ksn2/plant4you/readme.txt

git pull   to begin/ downloard new documents

working......

git status  verify not needed

git add *     add all documents

git commit -m "COMMENT"   commentiares  prepare uploard

git push    to finish    uploard

DO NOT REOMOVE ANYTHING
