ksn2/plant4you/Eagle files/projectdesign_v1.0_10ku.xlsx

Part Number | Manufacturer | Customer Ref | Qty for 1u | Qty for 10ku | Price (USD) | Extended Price (USD) | Buy Now Link
C1608X7S1C225K080AC | TDK Corporation of America | C1, C4 | 2 | 20000 | $0.0638 | $1275.2000 | BUY NOW (http://www.findchips.com/buyNow/REF31cc2016cbec4e1b73caca7a0ee76e62_1513636588540)
CL10C2R2BB8NNNC | Samsung Electro-Mechanics | C17, C18 | 2 | 20000 | $0.0047 | $94.0000 | BUY NOW (http://www.findchips.com/buyNow/REF4bc2c40f38a14b543147b131e5790f90_1513636588540)
GRM188R60J106KE47D | Murata Manufacturing Co Ltd | C2, C3, C5, C6, C7 | 5 | 50000 | $0.0260 | $1300.0000 | BUY NOW (http://www.findchips.com/buyNow/REF58e51c0d0c70fecfa8ddc1131338d9a8_1513636588540)
CL10B105KP8NNNC | Samsung Electro-Mechanics | C20 | 1 | 10000 | $0.0044 | $44.0000 | BUY NOW (http://www.findchips.com/buyNow/REF90674f444396d27626bddeaa0b6934d4_1513636588540)
C0402C104K8RACTU | KEMET Corporation | C8, C9, C11, C12, C13, C14, C15, C16 | 8 | 80000 | $0.0060 | $480.0000 | BUY NOW (http://www.findchips.com/buyNow/REF71b78460a80cd47184843153eb02b417_1513636588540)
1051330011 | Woodhead Molex | CN1 | 1 | 10000 | $0.3904 | $3904.0000 | BUY NOW (http://www.findchips.com/buyNow/REF39c8833fe5188c6ea10376dab894bd50_1513636588540)
S2B-PH-SM4-TB(LF)(SN) | JST Manufacturing | CN2 | 1 | 10000 | $0.3155 | $3155.2000 | BUY NOW (http://www.findchips.com/buyNow/REFdc34bc6eb77acfec8c5d5d912a447aa0_1513636588540)
1N4148W-7-F | SPC Multicomp | D1, D2, D3, D4 | 4 | 40000 | $0.0120 | $480.0000 | BUY NOW (http://www.findchips.com/buyNow/REFe81a3cc093ba35d7bd46322f07d6a9f4_1513636588540)
TPS73233DBVT | Texas Instruments | IC1, IC2 | 2 | 20000 | $0.8500 | $17000.0000 | BUY NOW (http://www.findchips.com/buyNow/REFb6842c236441bab0f91dbeda015d57be_1513636588540)
MCP73833T-AMI/UN | Microchip Technology Inc | IC3 | 1 | 10000 | $0.6902 | $6902.0000 | BUY NOW (http://www.findchips.com/buyNow/REF55941f5b56751ebd3785dd3f0201f68b_1513636588540)
ATMEGA32U4RC-AUR | Microchip Technology Inc | IC4 | 1 | 10000 | $3.1300 | $31300.0000 | BUY NOW (http://www.findchips.com/buyNow/REF8bca17bd0259d9e86a0e12016a883257_1513636588540)
TLV379IDBVT | Texas Instruments | IC5 | 1 | 10000 | $0.2648 | $2648.0000 | BUY NOW (http://www.findchips.com/buyNow/REFf75a09880d05cdd1fed671623121a951_1513636588540)
61302221021 | Wurth Electronics Midcom | JP1 | 1 | 10000 | $0.7200 | $7200.0000 | BUY NOW (http://www.findchips.com/buyNow/REFa60be67211f2c4d99c35d25056d53b82_1513636588540)
PRPC025SAAN-RC | Sullins Connector Solutions | JP2 | 1 | 10000 | $0.2395 | $2394.8000 | BUY NOW (http://www.findchips.com/buyNow/REF61615c5b441bf2df4b6aa6ea3f7fab22_1513636588540)
LQM18PN3R3MGHD | Murata Manufacturing Co Ltd | L1, L2 | 2 | 20000 | $0.1896 | $3792.8000 | BUY NOW (http://www.findchips.com/buyNow/REF9090d8d61cc638534848b6033a871ce6_1513636588540)
WP154A4SEJ3VBDZGW/CA | Kingbright | LD1, LD2 | 2 | 20000 | $0.7312 | $14625.0000 | BUY NOW (http://www.findchips.com/buyNow/REF5d757407a6ffb510d0d9354856d090c1_1513636588540)
TLHO4400 | Vishay Intertechnologies | LD3 | 1 | 10000 | $0.0750 | $750.0000 | BUY NOW (http://www.findchips.com/buyNow/REF917523fed8f101329e66d244f764203b_1513636588540)
TLLG4400 | Vishay Semiconductors | LD4 | 1 | 10000 | $0.0735 | $735.0000 | BUY NOW (http://www.findchips.com/buyNow/REF6d5565322f12cf7d5e41bd07beffc5d7_1513636588540)
TLHK4600 | Vishay Intertechnologies | LD5 | 1 | 10000 | $0.1190 | $1190.0077 | BUY NOW (http://www.findchips.com/buyNow/REF79d3afbc32bd740dc5758215182803e2_1513636588540)
CEM-1203(42) | CUI Inc | LS1 | 1 | 10000 | $0.4040 | $4040.0000 | BUY NOW (http://www.findchips.com/buyNow/REF7d50d23c2ce48577a59e85f5f175b530_1513636588540)
T2N7002BK,LM | Toshiba America Electronic Components | Q1, Q2, Q3, Q4, Q5 | 5 | 50000 | $0.0170 | $850.0000 | BUY NOW (http://www.findchips.com/buyNow/REFca5b4d7ef96829eccc1e313a39a78037_1513636588540)
ERJ-3EKF2001V | Panasonic Electronic Components | R01, R02, R03, R09, R27, R28, R29 | 7 | 70000 | $0.0043 | $301.0000 | BUY NOW (http://www.findchips.com/buyNow/REFb075da1d5211cd85118a7cf6484cde3e_1513636588540)
161 | Adafruit Industries | R04 | 1 | 10000 | $0.9500 | $9500.0000 | BUY NOW (http://www.findchips.com/buyNow/REF6a314e36687fc0da8680494a4f7a349a_1513636588540)
RC0603JR-0710KL | YAGEO Corporation | R05, R10, R11, R12, R14, R15, R16, R19, R20, R21, R22, R23, R24, R25, R26, R30, R31 | 17 | 170000 | $0.0010 | $170.0000 | BUY NOW (http://www.findchips.com/buyNow/REF34265a9543ca0835692e1984bb5d935d_1513636588540)
RC0603FR-071KL | YAGEO Corporation | R06, R07, R08 | 3 | 30000 | $0.0010 | $30.0000 | BUY NOW (http://www.findchips.com/buyNow/REFd454bf327c9d5965a2a90ef37af13bb2_1513636588540)
RC0603JR-07330RL | YAGEO Corporation | R13 | 1 | 10000 | $0.0010 | $10.0000 | BUY NOW (http://www.findchips.com/buyNow/REF4f86663b7a59056d9bbcf79774f7c605_1513636588540)
RC0603JR-0722RL | YAGEO Corporation | R17, R18 | 2 | 20000 | $0.0010 | $20.0000 | BUY NOW (http://www.findchips.com/buyNow/REF3a03c2ac452e0722e72d15b519151ccf_1513636588540)
ABM3B-8.000MHZ-B2-T | Abracon Corporation | Y1 | 1 | 10000 | $0.3000 | $3000.0000 | BUY NOW (http://www.findchips.com/buyNow/REF757090e3209aa773c61a521414b3ed73_1513636588540)
P160KNP-0QC20B100K | TT electronics / BI Technologies | Potentiometer | 2 | 20000 | $0.3410 | $6820.0000 | BUY NOW (http://www.findchips.com/buyNow/REF6512f6ffeaa8bfea2acfd3cbcc9c324e_1513636588540)
RD1113112R | E-Switch Inc | Switch ON/OFF | 1 | 10000 | $0.4169 | $4169.5000 | BUY NOW (http://www.findchips.com/buyNow/REFc520fa1013096d44ad12100beb26c609_1513636588540)
SEN-13285 | SparkFun Electronics | PIR detector | 1 | 10000 | $9.9500 | $99500.0000 | BUY NOW (http://www.findchips.com/buyNow/REF5ceba9085f9713bd4fbd4c60f31d63c7_1513636588540)
59630-1-T-02-F | Littelfuse Inc | Level Sensor | 1 | 10000 | $3.6525 | $36524.9890 | BUY NOW (http://www.findchips.com/buyNow/REFe3c43dcab0f1088a73c3406c82f90f47_1513636588540)
1227-L | Davies Molding LLC | button / knobs | 4 | 40000 | $0.5250 | $21000.0000 | BUY NOW (http://www.findchips.com/buyNow/REF950a1c00edf912bbf072bdf14b88454a_1513636588540)
Total: |  |  |  |  | $24.4704 | $285205.4967
List URL http://www.... (http://www.findchips.com/listExportUrl/REFb71df46670677b38f3765c6fa840ecae_1513636588540)
