ksn2/plant4you/Eagle files/projectdesign_v1.0.xlsx

Part Number | Manufacturer | Customer Ref | Requested Qty | Price (USD) | Extended Price (USD) | Buy Now Link | Datasheet Link
C1608X7S1C225K080AC | TDK Corporation of America | C1, C4 | 6 | $0.2700 | $1.6200 | BUY NOW (http://www.findchips.com/buyNow/REFf66b751d84ed0f5c17d27a477af12626_1511742619100)
CL10C2R2BB8NNNC | Samsung Electro-Mechanics | C17, C18 | 6 | $0.1000 | $0.6000 | BUY NOW (http://www.findchips.com/buyNow/REFc5286166dd49acb642db3adea9a44607_1511742619100) | DOWNLOAD (http://www.findchips.com/downloadDs/REF1f4d97d7e42095225d08ddc651603f1e_1511742619100)
GRM188R60J106KE47D | Murata Manufacturing Co Ltd | C2, C3, C5, C6, C7 | 15 | $0.1090 | $1.6350 | BUY NOW (http://www.findchips.com/buyNow/REFb6cca2449dfc87572ddc5fba2605cb44_1511742619100) | DOWNLOAD (http://www.findchips.com/downloadDs/REF019bca1aee656d7ac1753f8d0c4d76cc_1511742619100)
CL10B105KP8NNNC | Samsung Electro-Mechanics | C20 | 3 | $0.1000 | $0.3000 | BUY NOW (http://www.findchips.com/buyNow/REF77f5892608f1419121ff32fcdfdb78a2_1511742619100) | DOWNLOAD (http://www.findchips.com/downloadDs/REF6c7af745d2b4565f88028a2741715127_1511742619100)
C0402C104K8RACTU | KEMET Corporation | C8, C9, C11, C12, C13, C14, C15, C16 | 24 | $0.0330 | $0.7920 | BUY NOW (http://www.findchips.com/buyNow/REFa5c6ad6ed951c9613644b0c759223baf_1511742619100) | DOWNLOAD (http://www.findchips.com/downloadDs/REF34f89f49994c7fe76e5298d0db0d848e_1511742619100)
1051330011 | Molex | CN1 | 3 | $1.0600 | $3.1800 | BUY NOW (http://www.findchips.com/buyNow/REFa73fe93963815aad48f86f9a9810aae7_1511742619100)
S2B-PH-SM4-TB(LF)(SN) | JST Manufacturing | CN2 | 3 | $0.5800 | $1.7400 | BUY NOW (http://www.findchips.com/buyNow/REF6368ca78605b86df658b20e4bdfd3f86_1511742619100) | DOWNLOAD (http://www.findchips.com/downloadDs/REF21815601e099eef7dc836e262553e640_1511742619100)
1N4148W-7-F | Diodes Incorporated | D1, D2, D3, D4 | 12 | $0.1640 | $1.9680 | BUY NOW (http://www.findchips.com/buyNow/REF012d256c0f24fd18d2a83f3bec859747_1511742619100) | DOWNLOAD (http://www.findchips.com/downloadDs/REF70821d2a931a5c306895712638c58a9a_1511742619100)
TPS73233DBVT | Texas Instruments | IC1, IC2 | 6 | $1.5700 | $9.4200 | BUY NOW (http://www.findchips.com/buyNow/REFd1458502e79fef33ecda44f013d2832b_1511742619100) | DOWNLOAD (http://www.findchips.com/downloadDs/REF4627096593f59883d910f3811baa2f1d_1511742619100)
MCP73833T-AMI/UN | Microchip Technology Inc | IC3 | 3 | $0.8900 | $2.6700 | BUY NOW (http://www.findchips.com/buyNow/REF0acb44e07918c3e2da592dfd7adbda82_1511742619100) | DOWNLOAD (http://www.findchips.com/downloadDs/REFc16c9a63c8e0155e4dbd9554bb5b1c9d_1511742619100)
ATMEGA32U4RC-AUR | Microchip Technology Inc | IC4 | 3 | $4.2900 | $12.8700 | BUY NOW (http://www.findchips.com/buyNow/REFb91479fa1f48abb75d063cb36a217ecc_1511742619100)
TLV379IDBVT | Texas Instruments | IC5 | 3 | $0.7800 | $2.3400 | BUY NOW (http://www.findchips.com/buyNow/REF6a3a97474f5e63c49e5ae6d3cdcc2bd5_1511742619100) | DOWNLOAD (http://www.findchips.com/downloadDs/REF2c472c6e22e121a1499769ffbed5d0ea_1511742619100)
61302221021 | Wurth Electronics Midcom | JP1 | 3 | $1.4800 | $4.4400 | BUY NOW (http://www.findchips.com/buyNow/REFd0724fc2f9bac6cddea9f2bb1691e8f2_1511742619100)
PRPC025SAAN-RC | Sullins Connector Solutions | JP2 | 3 | $0.5500 | $1.6500 | BUY NOW (http://www.findchips.com/buyNow/REF89ff7de83079121413192e5261189aa6_1511742619100)
LQM18PN3R3MGHD | Murata Manufacturing Co Ltd | L1, L2 | 6 | $0.4500 | $2.7000 | BUY NOW (http://www.findchips.com/buyNow/REF6983d0bacdc3b7179c31344df58abc18_1511742619100)
WP154A4SEJ3VBDZGW/CA | Kingbright | LD1, LD2 | 6 | $2.0500 | $12.3000 | BUY NOW (http://www.findchips.com/buyNow/REF72d246a25f8a70af345e91291218c92f_1511742619100)
TLHO4400 | Vishay Semiconductors | LD3 | 3 | $0.5200 | $1.5600 | BUY NOW (http://www.findchips.com/buyNow/REF5b3f9c1bb6ac76b9f6830ea67775394e_1511742619100) | DOWNLOAD (http://www.findchips.com/downloadDs/REF6d4dd64f37a5870487dc8fe0a707be59_1511742619100)
TLLG4400 | Vishay Semiconductors | LD4 | 3 | $0.5000 | $1.5000 | BUY NOW (http://www.findchips.com/buyNow/REF671e45b739c328b1c66ff7fe57683592_1511742619100) | DOWNLOAD (http://www.findchips.com/downloadDs/REFd5734a7edfee3f9d948d6d67250f2df7_1511742619100)
TLHK4600 | Vishay Semiconductors | LD5 | 3 | $0.4400 | $1.3200 | BUY NOW (http://www.findchips.com/buyNow/REFb7131e319e8513b46af3da1528d08bba_1511742619100) | DOWNLOAD (http://www.findchips.com/downloadDs/REFf0eb19955a43db84a89d9b4394bf1b00_1511742619100)
CEM-1203(42) | CUI Inc | LS1 | 3 | $0.9700 | $2.9100 | BUY NOW (http://www.findchips.com/buyNow/REFb883de1dff0d67a19fbf12e010912da7_1511742619100)
T2N7002BK,LM | Toshiba America Electronic Components | Q1, Q2, Q3, Q4, Q5 | 15 | $0.1710 | $2.5650 | BUY NOW (http://www.findchips.com/buyNow/REF7df44703fd0e53d011f4c2e0d8a4afd9_1511742619100)
ERJ-3EKF2001V | Panasonic Electronic Components | R01, R02, R03, R09, R27, R28, R29 | 21 | $0.0570 | $1.1970 | BUY NOW (http://www.findchips.com/buyNow/REFe0275140c9dfc09d22c0b8cd24d6f4d1_1511742619100) | DOWNLOAD (http://www.findchips.com/downloadDs/REFd24328abf190c49f8a6240d556954945_1511742619100)
161 | Adafruit Industries | R04 | 3 | $0.9500 | $2.8500 | BUY NOW (http://www.findchips.com/buyNow/REF60ae9b95788bac3980c18a843a1e1d8b_1511742619100)
RC0603JR-0710KL | YAGEO Corporation | R05, R10, R11, R12, R14, R15, R16, R19, R20, R21, R22, R23, R24, R25, R26, R30, R31 | 51 | $0.0110 | $0.5610 | BUY NOW (http://www.findchips.com/buyNow/REFc91f549d2d90fc0bbecf7969e530a23f_1511742619100) | DOWNLOAD (http://www.findchips.com/downloadDs/REFb57fbb8a35e9925bec2339074d13de73_1511742619100)
RC0603FR-071KL | YAGEO Corporation | R06, R07, R08 | 9 | $0.1000 | $0.9000 | BUY NOW (http://www.findchips.com/buyNow/REF8fb07a13f801c52311ce77ef6def12a6_1511742619100) | DOWNLOAD (http://www.findchips.com/downloadDs/REFf692b2c74ec9d3cc190921a5e43ae7c4_1511742619100)
RC0603JR-07330RL | YAGEO Corporation | R13 | 3 | $0.1000 | $0.3000 | BUY NOW (http://www.findchips.com/buyNow/REF654be526baca869dc6ee3da60667c46d_1511742619100) | DOWNLOAD (http://www.findchips.com/downloadDs/REF1186b163d541c4794ce3fb4ad02fb3fa_1511742619100)
RC0603JR-0722RL | YAGEO Corporation | R17, R18 | 6 | $0.1000 | $0.6000 | BUY NOW (http://www.findchips.com/buyNow/REF78f071630f98e2ce599816b429543163_1511742619100) | DOWNLOAD (http://www.findchips.com/downloadDs/REF7aaa764fddc9c214c2c5ca3bd74b0005_1511742619100)
ABM3B-8.000MHZ-B2-T | Abracon Corporation | Y1 | 3 | $0.5100 | $1.5300 | BUY NOW (http://www.findchips.com/buyNow/REF8c2bad44a26a58ff95615c68a71c80fa_1511742619100)
P160KNP-0QC20B100K | TT electronics / BI Technologies | Potentiometer | 6 | $0.7600 | $4.5600 | BUY NOW (http://www.findchips.com/buyNow/REF2712a89083bef628c255b89755f665e8_1511742619100)
RD1113112R | E-Switch Inc | Switch ON/OFF | 2 | $0.6700 | $1.3400 | BUY NOW (http://www.findchips.com/buyNow/REF0045482cb7ad0e921a08addfb43c8513_1511742619100)
SEN-13285 | SparkFun Electronics | PIR detector | 2 | $9.9500 | $19.9000 | BUY NOW (http://www.findchips.com/buyNow/REF6ac73788b93b1b05acd4217cd8745597_1511742619100)
59630-1-T-02-F | Littelfuse Inc | Level Sensor | 1 | $7.1300 | $7.1300 | BUY NOW (http://www.findchips.com/buyNow/REF958e13c775bc0716d519fc51487d352f_1511742619100)
1227-L | Davies Molding LLC | button | 4 | $1.0900 | $4.3600 | BUY NOW (http://www.findchips.com/buyNow/REF9d3521369fd96be21a00488a76209cf6_1511742619100)
2003 | Adafruit Industries | wires | 1 | $0.7500 | $0.7500 | BUY NOW (http://www.findchips.com/buyNow/REFdd2375e230017ac7052d605e40d0c0c6_1511742619100)
2004 | Adafruit Industries | wires | 1 | $0.7500 | $0.7500 | BUY NOW (http://www.findchips.com/buyNow/REF9f839b3c856ede117d703e720ed7519c_1511742619100)
2001 | Adafruit Industries | wires | 1 | $0.7500 | $0.7500 | BUY NOW (http://www.findchips.com/buyNow/REF2a5c5912f52e5bdeeb570d007e2fbad9_1511742619100)
2005 | Adafruit Industries | wires | 1 | $0.7500 | $0.7500 | BUY NOW (http://www.findchips.com/buyNow/REF571c9d593df2cfcef382c5c8c4de9343_1511742619100)
2006 | Adafruit Industries | wires | 1 | $0.7500 | $0.7500 | BUY NOW (http://www.findchips.com/buyNow/REFac832c068813ad7eec9bb011f5001f67_1511742619100)
2002 | Adafruit Industries | wires | 1 | $0.7500 | $0.7500 | BUY NOW (http://www.findchips.com/buyNow/REF74df2bf7fa230bc32681d80d5187b0e0_1511742619100)
A02KR02KR26E51B | JST Manufacturing | battery connector head | 2 | $0.8600 | $1.7200 | BUY NOW (http://www.findchips.com/buyNow/REFa8ba24af6574b9d00f0fedf2d55a5b6f_1511742619100)
50579002 | Molex | wire head | 20 | $0.3150 | $6.3000 | BUY NOW (http://www.findchips.com/buyNow/REFa9f090160a2910a77b422dad1c59c576_1511742619100) | DOWNLOAD (http://www.findchips.com/downloadDs/REF4f7ca95ae4dcf72a3f6897b211605166_1511742619100)
1903115-2 | TE Connectivity Ltd | wire head | 20 | $0.2340 | $4.6800 | BUY NOW (http://www.findchips.com/buyNow/REF2e6c435b52858ef2cd3f6d3dbd0b8d43_1511742619100)
104481-2 | TE Connectivity Ltd | wire head | 20 | $0.1350 | $2.7000 | BUY NOW (http://www.findchips.com/buyNow/REF591973ddf7f70e00231eeb661dc71fe9_1511742619100) | DOWNLOAD (http://www.findchips.com/downloadDs/REF733cad3b3655ea9fa18c4a471f4d21d7_1511742619100)
Q2-F-3/64-01-QB48IN-25 | Qualtek Electronics Corporation | heat shirnkable tube | 1 | $0.3700 | $0.3700 | BUY NOW (http://www.findchips.com/buyNow/REF7b3daf2aafc5852abaa0eb33fb0964ff_1511742619100)
Total |  |  |  |  | $135.5780
List URL http://www.... (http://www.findchips.com/listExportUrl/REF6744603b5e4ae30d0f72f0af92319cf2_1511742619100)
