ksn2/plant4you/Eagle files/Project_design_v1.1.pdf

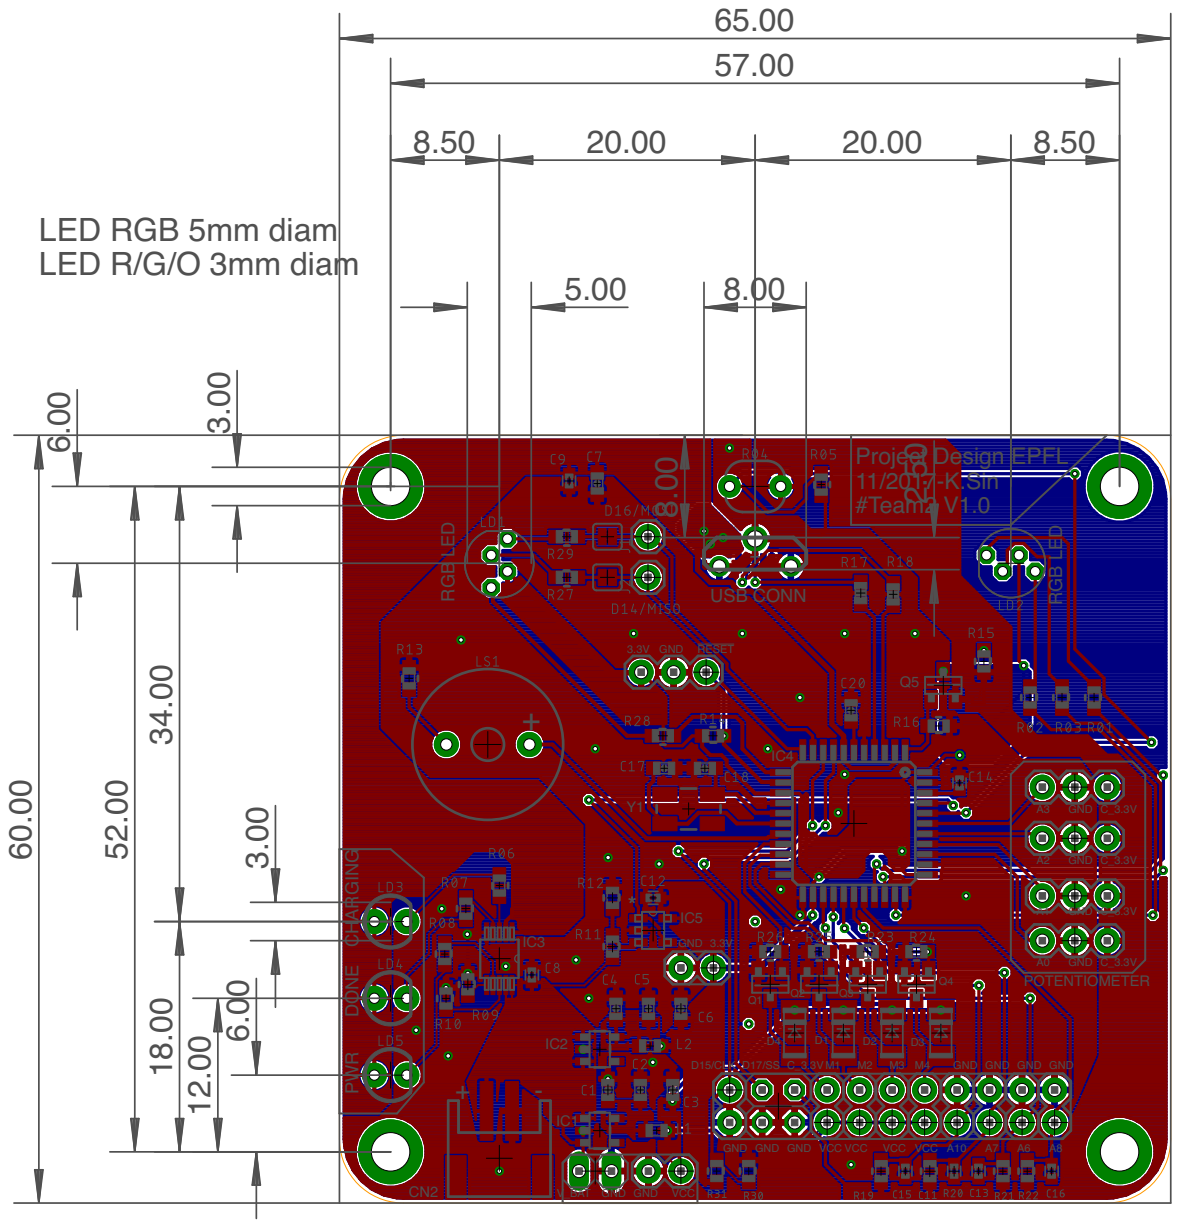
[picture p1: page 1]

3.3V GND RESET

GND GND

IC3 | GND 3.3V

VCC VCC
