ksn2/plant4you/Eagle files/Project_design_v1.0_top.pdf

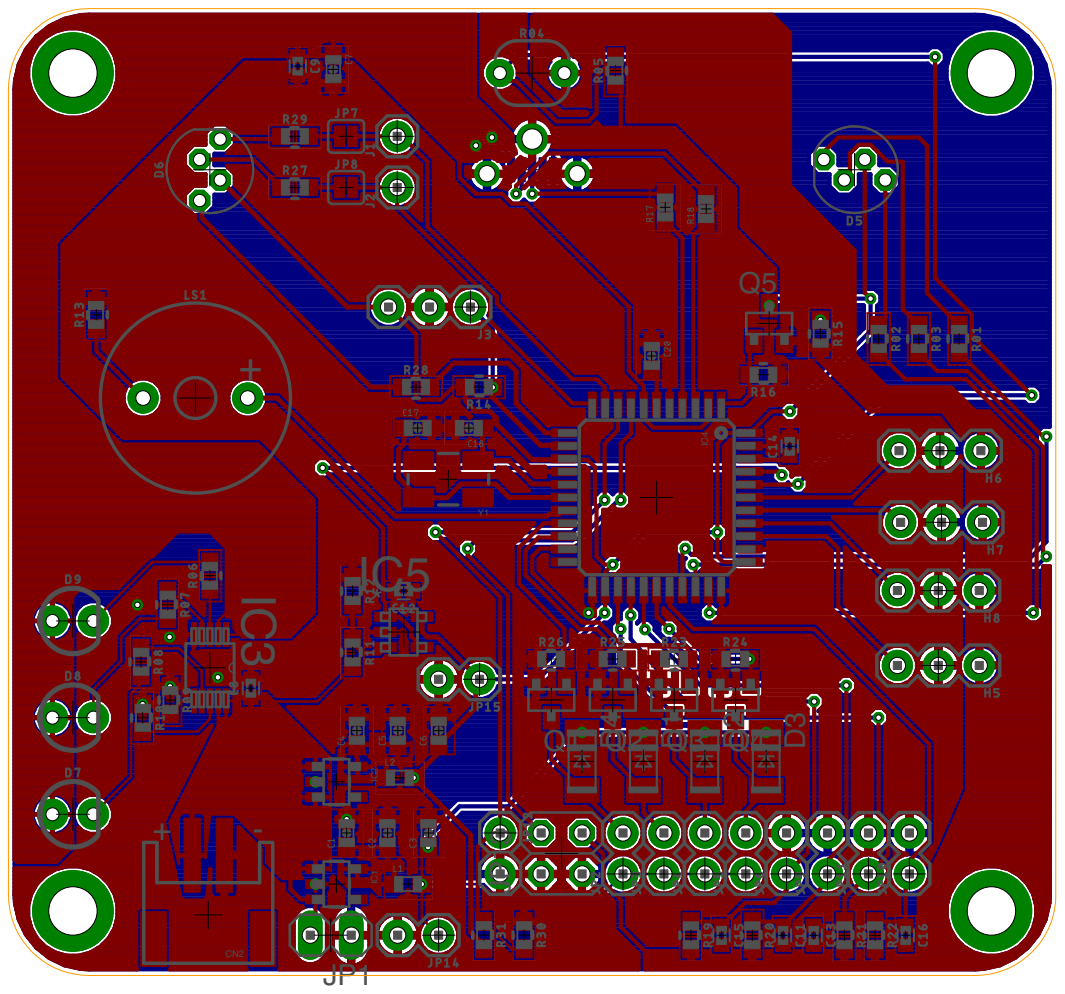
[picture p2: page 1]

Y1
IC5
