ksn2/plant4you/Eagle files/Project_design_v1.0.pdf

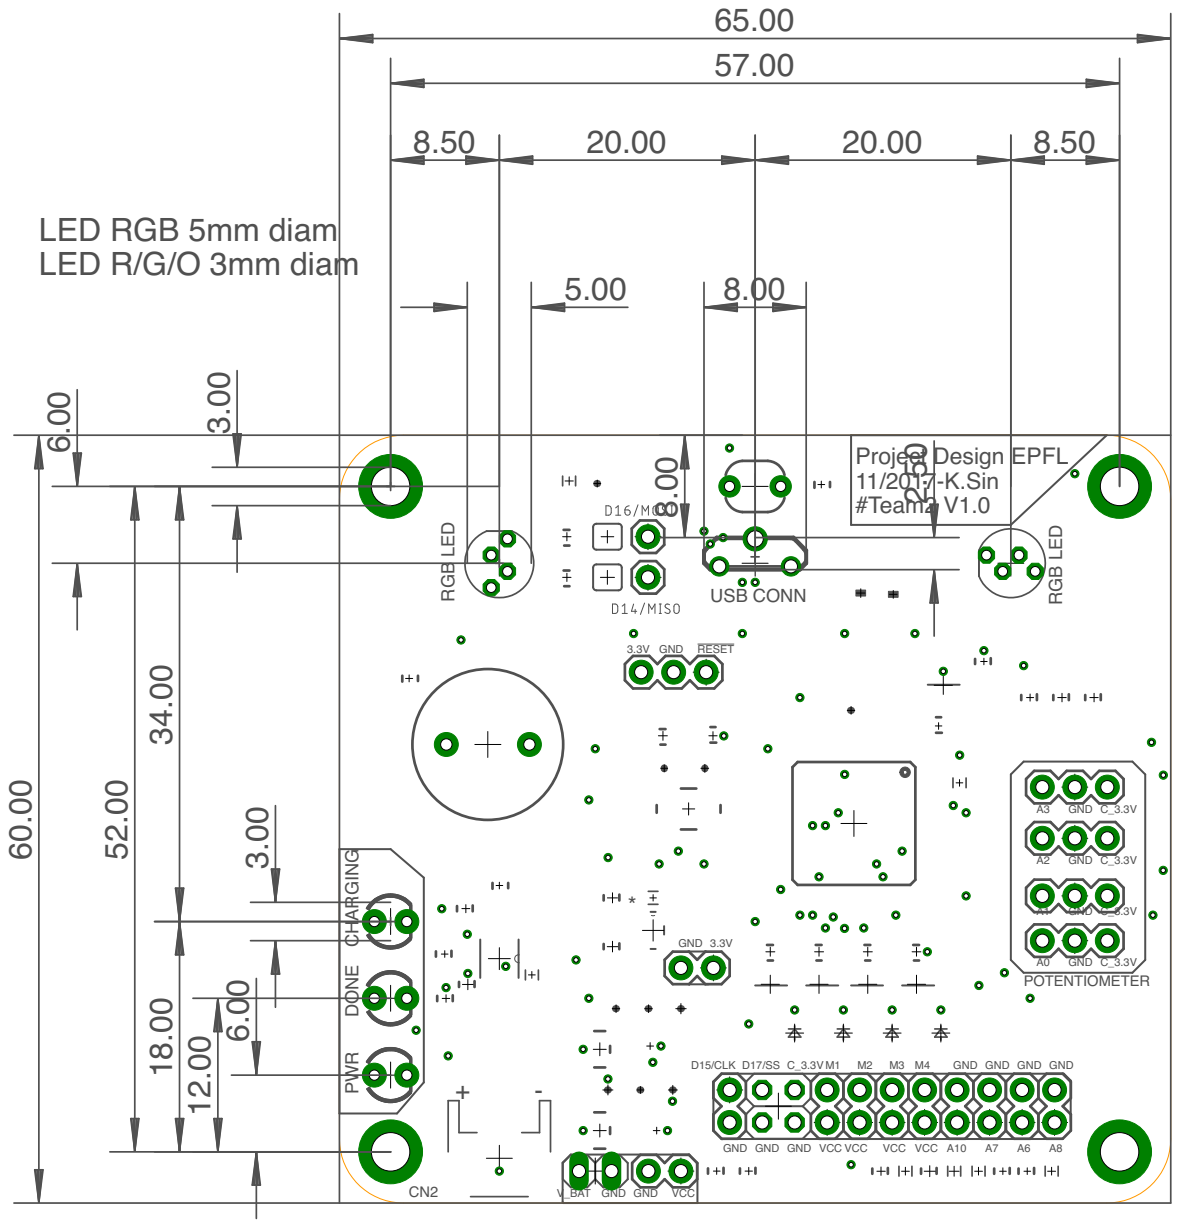
[picture p3: page 1]

GND GND
