ksn2/plant4you/Eagle files/Project_design_v1.0.brd

## EAGLE design Eagle files/Project_design_v1.0.brd (2017-11-29)

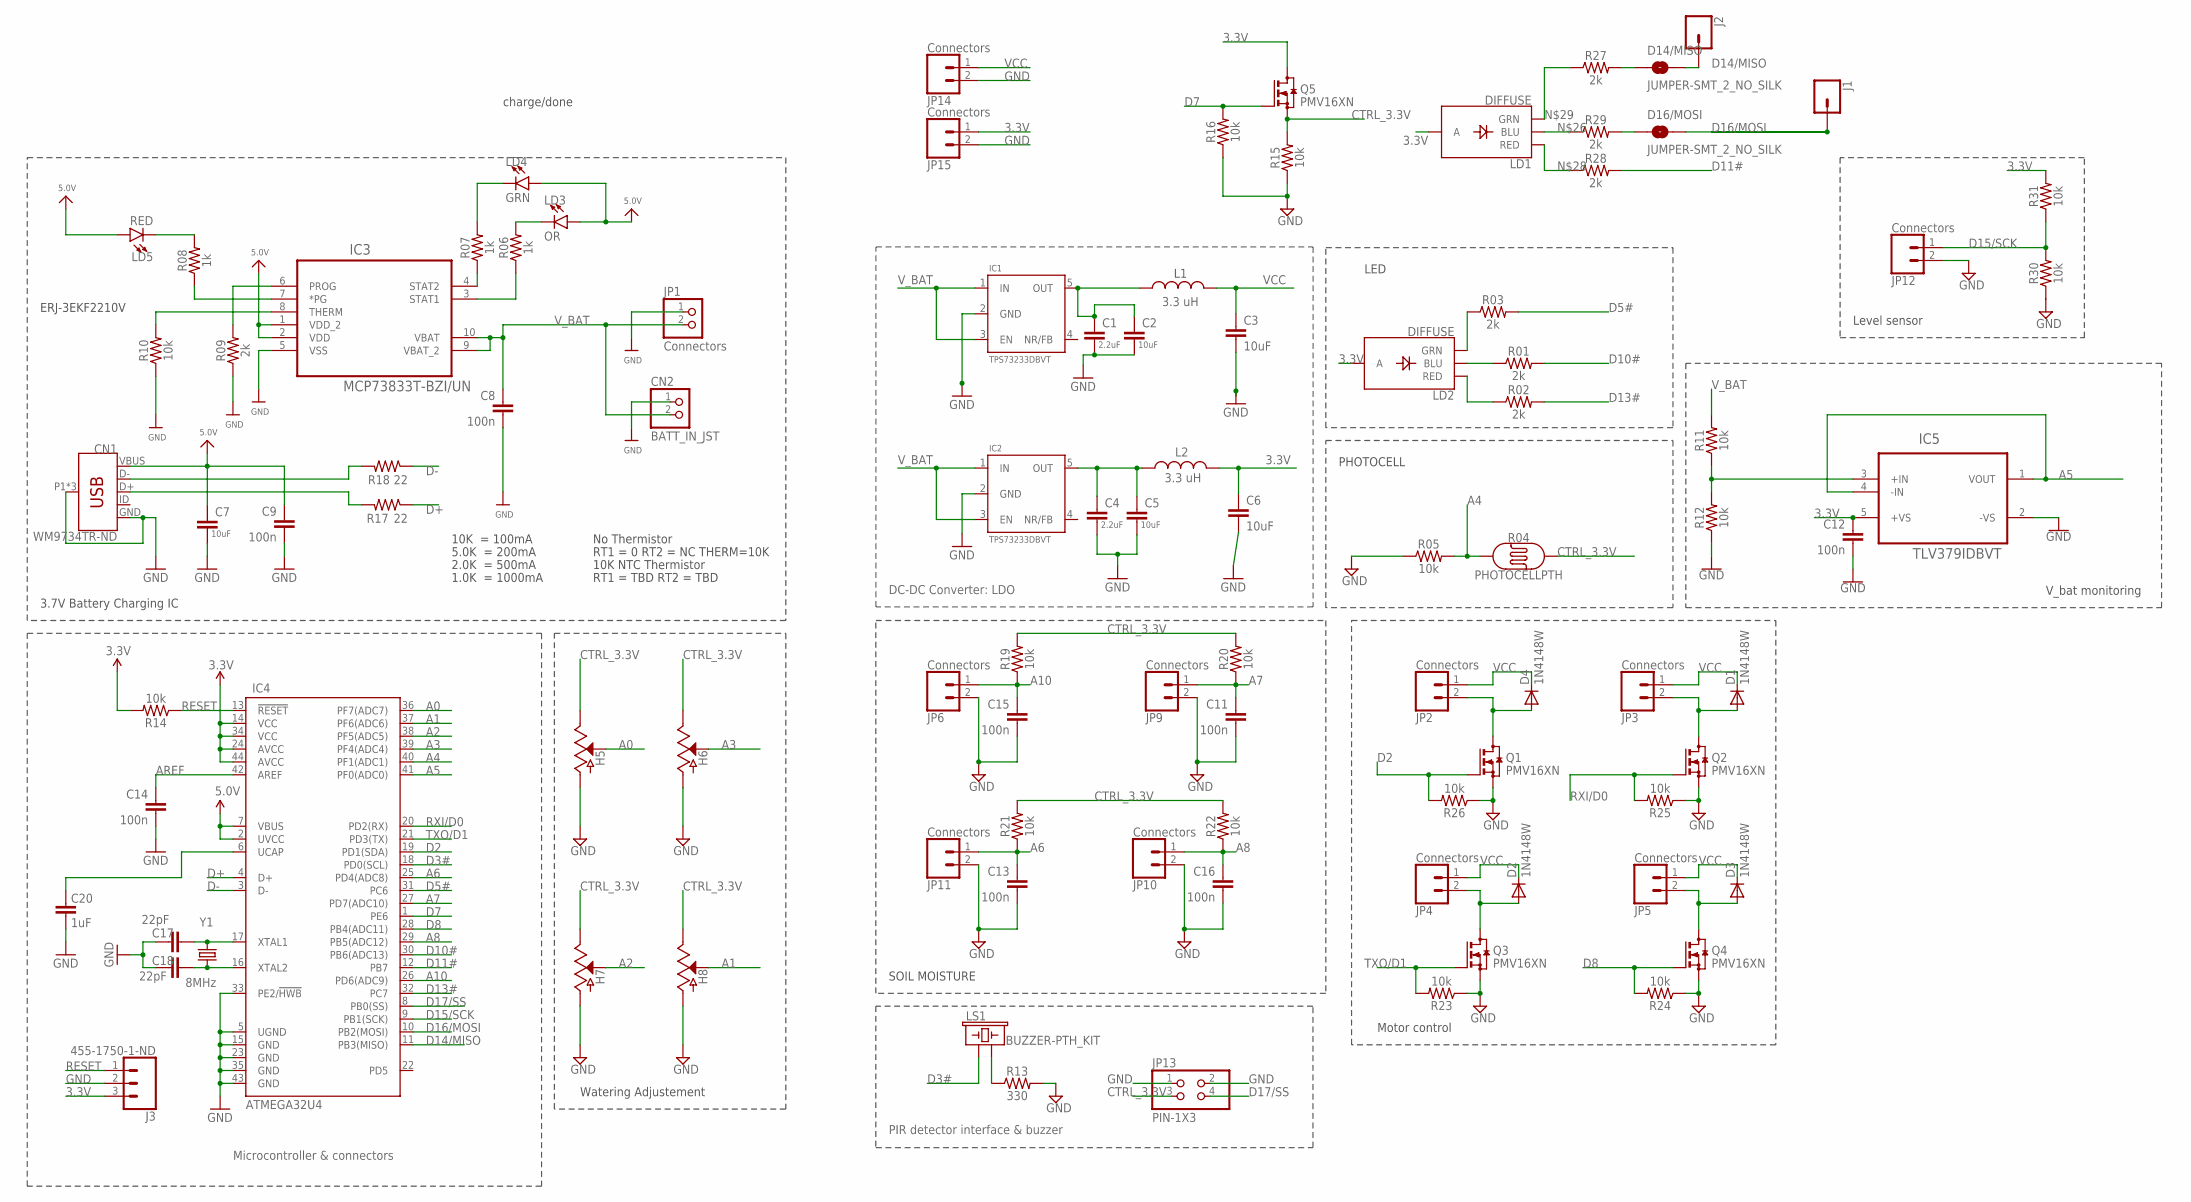
[picture p4: schematic Project_design_v1.0.sch]

Parts:
C1, C4: 2.2uF; 0603-CAP; PARTNO C1608X7S1C225K080AC
C2, C3, C5, C6, C7: 10uF; 0603-CAP; PARTNO GRM188R60J106ME47D
C8, C9, C11, C12, C13, C14, C15, C16: 100n; 0402; PARTNO CGA2B3X7R1E104K050BB
C17, C18: 22pF; 0603-CAP; PARTNO CL10C2R2BB8NNNC
C20: 1uF; 0603-CAP; PARTNO CL10B105KP8NNNC
CN1: WM9734TR-ND; USB-B-MICRO-SMD_VERT; PARTNO 1051330011
CN2: BATT_IN_JST; JSTPH2; PARTNO B2B-XH-A(LF)(SN)
D1, D2, D3, D4: 1N4148W; SOD-123_MINI-SMA; PARTNO 1N4148W
D14/MISO, D16/MOSI: JUMPER-SMT_2_NO_SILK; SMT-JUMPER_2_NO_SILK
H5: POT1; SOIL_MOISTURE; PARTNO SEN-13322
H6: POT2; SOIL_MOISTURE; PARTNO SEN-13322
H7: POT3; SOIL_MOISTURE; PARTNO SEN-13322
H8: POT4; SOIL_MOISTURE; PARTNO SEN-13322
IC1, IC2: TPS73233DBVT; SOT23-5; PARTNO TPS73233DBVT
IC3: MCP73833T-BZI/UN; SOP50P490X110-10N
IC4: ATMEGA32U4; TQFP44; PARTNO ATMEGA32U4RC-MUR
IC5: TLV379IDBVT; SOT95P280X145-5N; PARTNO TLV379IDBVT
J1, J2: CONN_01; 1X01
J3: 455-1750-1-ND; 1X03
JP1: Connectors; 1X02; PARTNO /
JP2, JP3, JP4, JP5, JP6, JP9, JP10, JP11, JP12, JP14, JP15: Connectors; 1X02; PARTNO M20-9960245
JP13: PIN-1X3; 2X02; PARTNO M22-2040805
L1, L2: 3.3 uH; 0603; PARTNO LQM18PN3R3MGHD
LD1, LD2: DIFFUSE; LED-RGB_THRU_5MM; PARTNO WP154A4SEJ3VBDZGW/CA
LD3: OR; LED_3MM; PARTNO TLHO4600
LD4: GRN; LED_3MM; PARTNO TLLG4400
LD5: RED; LED_3MM; PARTNO TLHK4600
LS1: BUZZER-PTH_KIT; BUZZER-12MM-KIT; PARTNO CEM-1203(42)
Q1, Q2, Q3, Q4, Q5: PMV16XN; SOT23; PARTNO PMV16XNR
R01, R02, R03, R09, R27, R28, R29: 2k; 0603; PARTNO ERJ-PA3F2001V
R04: PHOTOCELLPTH; PHOTOCELL; PARTNO 1528-2141-ND
R05, R10, R11, R12, R14, R15, R16, R19, R20, R21, R22, R23, R24, R25, R26, R30, R31: 10k; 0603; PARTNO ERA-3AEB103V
R06, R07, R08: 1k; 0603; PARTNO RC0603JR-07330RL
R13: 330; 0603; PARTNO RC0603JR-07330RL
R17, R18: 22; 0603-RES; PARTNO RC0603JR-0722RL
Y1: 8MHz; CRYSTAL-SMD-5X3; PARTNO ABM3C-8.000MHZ-D4Y-T

Connections:
3.3V: C6.1, C12.1, IC4.14 (VCC), IC4.24 (AVCC), IC4.34 (VCC), IC4.44 (AVCC), IC5.5 (+VS), J3.3, JP15.1, L2.2, LD1.3 (A), LD2.3 (A), Q5.3 (D), R14.2, R31.2
5.0V: C7.1, C9.1, CN1.VBUS, IC3.1 (VDD_2), IC3.2 (VDD), IC4.2 (UVCC), IC4.7 (VBUS), LD3.A, LD4.A, LD5.A
A0: H5.3 (VOUT), IC4.36 (PF7(ADC7))
A1: H8.3 (VOUT), IC4.37 (PF6(ADC6))
A2: H7.3 (VOUT), IC4.38 (PF5(ADC5))
A3: H6.3 (VOUT), IC4.39 (PF4(ADC4))
A4: IC4.40 (PF1(ADC1)), R04.1, R05.2
A5: IC4.41 (PF0(ADC0)), IC5.1 (VOUT), IC5.4 (-IN)
A6: C13.1, IC4.25 (PD4(ADC8)), JP11.1, R21.1
A7: C11.1, IC4.27 (PD7(ADC10)), JP9.1, R20.1
A8: C16.1, IC4.29 (PB5(ADC12)), JP10.1, R22.1
A10: C15.1, IC4.26 (PD6(ADC9)), JP6.1, R19.1
AREF: C14.1, IC4.42 (AREF)
CTRL_3.3V: H5.1 (VCC), H6.1 (VCC), H7.1 (VCC), H8.1 (VCC), JP13.3, Q5.2 (S), R04.2, R15.2, R19.2, R20.2, R21.2, R22.2
D2: IC4.19 (PD1(SDA)), Q1.1 (G), R26.2
D3#: IC4.18 (PD0(SCL)), LS1.+ (1)
D5#: IC4.31 (PC6), R03.2
D7: IC4.1 (PE6), Q5.1 (G), R16.2
D8: IC4.28 (PB4(ADC11)), Q4.1 (G), R24.2
D10#: IC4.30 (PB6(ADC13)), R01.2
D11#: IC4.12 (PB7), R28.2
D13#: IC4.32 (PC7), R02.2
D14/MISO: D14/MISO.2, IC4.11 (PB3(MISO)), J2.1
D15/SCK: IC4.9 (PB1(SCK)), JP12.1, R30.2, R31.1
D16/MOSI: D16/MOSI.2, IC4.10 (PB2(MOSI)), J1.1
D17/SS: IC4.8 (PB0(SS)), JP13.4
D+: IC4.4 (D+), R17.1
D-: IC4.3 (D-), R18.1
GND: C1.2, C2.2, C3.2, C4.2, C5.2, C6.2, C7.2, C8.2, C9.2, C11.2, C12.2, C13.2, C14.2, C15.2, C16.2, C17.2, C18.2, C20.1, CN1.GND, CN1.P1 (SHIELD), CN1.P2 (SHIELD), CN1.P3 (SHIELD), CN2.1, H5.2 (GND), H6.2 (GND), H7.2 (GND), H8.2 (GND), IC1.2 (GND), IC2.2 (GND), IC3.5 (VSS), IC4.5 (UGND), IC4.15 (GND), IC4.23 (GND), IC4.33 (PE2/!HWB), IC4.35 (GND), IC4.43 (GND), IC5.2 (-VS), J3.2, JP1.1, JP6.2, JP9.2, JP10.2, JP11.2, JP12.2, JP13.1, JP13.2, JP14.2, JP15.2, Q1.2 (S), Q2.2 (S), Q3.2 (S), Q4.2 (S), R05.1, R09.1, R10.1, R12.1, R13.2, R15.1, R16.1, R23.1, R24.1, R25.1, R26.1, R30.1
unnamed: LD2.2 (GRN), R03.1
unnamed: C4.1, C5.1, IC2.5 (OUT), L2.1
unnamed: LD3.K (C), R06.2
unnamed: LD4.K (C), R07.2
unnamed: IC3.4 (STAT2), R07.1
unnamed: IC3.3 (STAT1), R06.1
unnamed: IC3.7 (*PG), R08.1
unnamed: IC3.8 (THERM), R10.2
unnamed: C18.1, IC4.16 (XTAL2), Y1.1
unnamed: D4.A, JP2.2, Q1.3 (D)
unnamed: D1.A, JP3.2, Q2.3 (D)
unnamed: LD5.K (C), R08.2
unnamed: C1.1, C2.1, IC1.5 (OUT), L1.1
unnamed: D2.A, JP4.2, Q3.3 (D)
unnamed: D3.A, JP5.2, Q4.3 (D)
unnamed: IC3.6 (PROG), R09.2
unnamed: IC5.3 (+IN), R11.1, R12.2
unnamed: C17.1, IC4.17 (XTAL1), Y1.3 (2)
unnamed: C20.2, IC4.6 (UCAP)
unnamed: CN1.D-, R18.2
unnamed: CN1.D+, R17.2
unnamed: LS1.- (2), R13.1
unnamed: LD1.1 (BLU), R29.1
unnamed: LD1.4 (RED), R28.1
unnamed: LD1.2 (GRN), R27.1
unnamed: D16/MOSI.1, R29.2
unnamed: D14/MISO.1, R27.2
unnamed: LD2.1 (BLU), R01.1
unnamed: LD2.4 (RED), R02.1
RESET: IC4.13 (!RESET), J3.1, R14.1
RXI/D0: IC4.20 (PD2(RX)), Q2.1 (G), R25.2
TXO/D1: IC4.21 (PD3(TX)), Q3.1 (G), R23.2
VCC: C3.1, D1.C, D2.C, D3.C, D4.C, JP2.1, JP3.1, JP4.1, JP5.1, JP14.1, L1.2
V_BAT: C8.1, CN2.2, IC1.1 (IN), IC1.3 (EN), IC2.1 (IN), IC2.3 (EN), IC3.9 (VBAT_2), IC3.10 (VBAT), JP1.2, R11.2

Notes on the sheet:
LED
PHOTOCELL
SOIL MOISTURE
DC-DC Converter: LDO
10K = 100mA
5.0K = 200mA
2.0K = 500mA
1.0K = 1000mA
No Thermistor
RT1 = 0 RT2 = NC THERM=10K
10K NTC Thermistor
RT1 = TBD RT2 = TBD
3.7V Battery Charging IC
charge/done
Motor control
Level sensor
ERJ-3EKF2210V
Watering Adjustement
V_bat monitoring
Microcontroller & connectors
PIR detector interface & buzzer

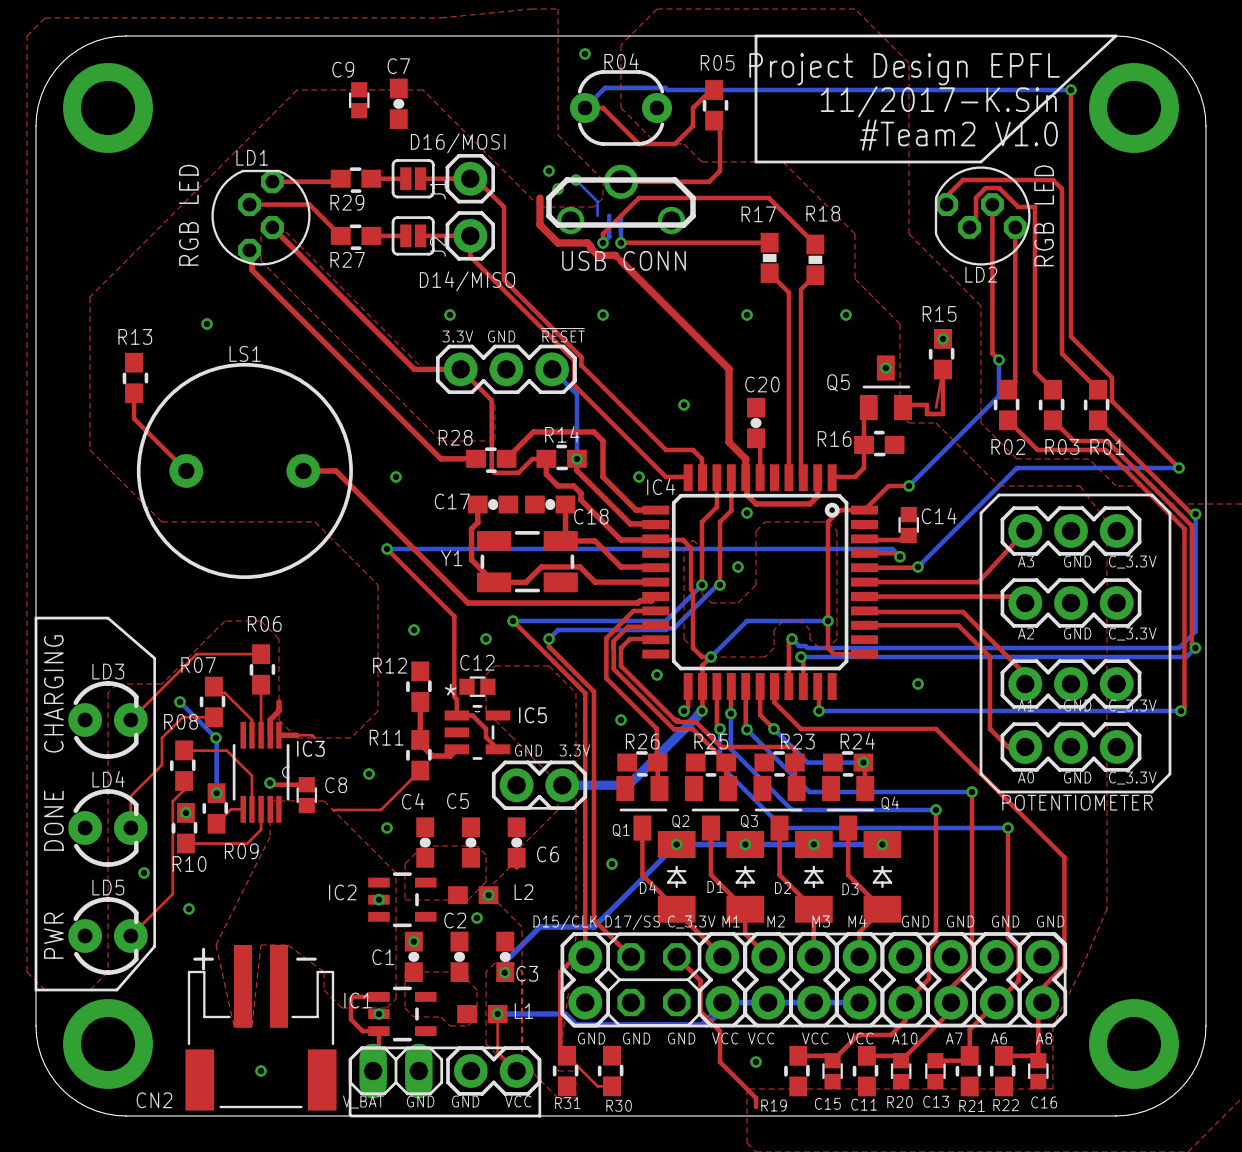
[picture p5: board Project_design_v1.0.brd from above]

Board: 2 copper layers, 65.0 x 60.0 mm, 96 parts (1 on the bottom side), 63 nets.
