ksn2/plant4you/Arduino_sketches/Plant4you_main/Define.h

//-------------CHANNEL definition-------------------//
#define CHANNEL1                    0
#define CHANNEL2                    1
#define CHANNEL3                    2
#define CHANNEL4                    3

//--------------RGB 1 LED PIN----------------------//
#define redPin1                     11
#define greenPin1                   16
#define bluePin1                    14

//--------------RGB 2 LED PIN----------------------//
#define redPin2                     13
#define greenPin2                   10
#define bluePin2                    5

//-------------Moisture Sensors PIN----------------//
#define moisturePin_channel1        A9  //OK
#define moisturePin_channel2        A6  //OK
#define moisturePin_channel3        A7  //OK
#define moisturePin_channel4        A11  //OK

//----------Potentiometer PIN----------------------//
#define pot_channel1                A3  //OK
#define pot_channel2                A2  //OK
#define pot_channel3                A0  //OK
#define pot_channel4                A1  //OK

//---------------Motor PIN-------------------------//
#define motorPin_channel1           8
#define motorPin_channel2           1  
#define motorPin_channel3           0  
#define motorPin_channel4           2

//---------Level sensor PIN------------------------//
#define level_sensorPin             15

//---------photocell PIN---------------------------//
#define photocellPin                A4  //OK

//---------Control of 3.3V PIN---------------------//
#define voltage_ctrlPin             7

//---------Battery voltage PIN---------------------//
#define batteryVoltagePin           A5 //OK

//---------Alarms PIN------------------------------//
#define PIRPin                      17
#define BuzzerPin                   3

//-----------Sensors constant parameters-----------//

#define Photocell_Value_Min         150
#define Photocell_Value_Max         550

#define Moisture_Value_Min          100
#define Moisture_Value_Max          1023

#define Battery_Voltage_Min         530
#define Battery_Voltage_Max         635

#define Water_Volume_Value_Min      0
#define Water_Volume_Value_Max      1023

//-------------color index-----------------------//
#define WATER                       500
#define PHOTOCELL                   0
