ksn2/plant4you/Arduino_sketches/Plant4you_main/Alarm.ino

void alarm_activation()
{
  if ( battery_voltage = LOW || water_level == HIGH)
  {
    //activation of PIR detector
    if (digitalRead(PIRPin) == LOW)
      activate_buzzer();
      

  Serial.print("PIR detector : "); Serial.println(digitalRead(PIRPin));
  Serial.println("-------------------------------");
  }
}

void activate_buzzer()
{ Led1.writeRGB(255,255,255);
  Led2.writeRGB(255,0,0);
  tone(3,2048);
  delay(3000);
  noTone(3);
  //delay(2000);
}

void setup_alarm()
{
  pinMode(BuzzerPin, OUTPUT);
  pinMode(PIRPin, INPUT_PULLUP);
}
