ksn2/plant4you/(commit log)

2017-10-27 doc de bellouard
2017-10-27 eagle first schemattic;template for futur use
    [Project_design_v1.0.brd, Project_design_v1.0.sch]
2017-11-02 first arduino sketch added to control the birghtness of 1 LED
2017-11-02 code to drive a RGB LED added
2017-11-02 Photocell code & Fading diode feedback
2017-11-02 schematic des temperature, soil moisture, led, brightness sensor
    [Project_design_v1.0.brd, Project_design_v1.0.sch]
2017-11-04 First arduino for the whole project: moisture sensors & motor;LEDs;analog reading of the birghtness sensor
2017-11-07 temperature sensor schmetatic & packages edited
    [Project_design_v1.0.brd, Project_design_v1.0.sch]
2017-11-08 arduino code updated & correcter
    [Photocell.ino, Plant4you_main.ino]
2017-11-09 MCU, charging IC & power supply implemented on the eagle schematics
    [Project_design_v1.0.brd, Project_design_v1.0.sch]
2017-11-09 corrections of few wire in the schematics
    [Project_design_v1.0.brd, Project_design_v1.0.sch]
2017-11-12 part number & potentiometer to select the ammount of water needed for each pot
    [Adafruit USB LiIon-LiPoly Charger.brd, Adafruit USB LiIon-LiPoly Charger.sch, BOM_Project_design_v1.0.xlsx, Project_design_v1.0.brd, Project_design_v1.0.sch]
2017-11-14 add comments on components
    [BOM_Project_design_v1.0.xlsx]
2017-11-15 schematic almose finished, part number edited, and PIR & buzzer added
    [BOM_Project_design_v1.0.xlsx, Project_design_v1.0.brd, Project_design_v1.0.sch]
2017-11-16 schematics design uptaded and adjusted for exportation for the MS2
    [BOM_Project_design_v1.0.xlsx, Project_design_v1.0.brd, Project_design_v1.0.sch]
2017-11-25 PCB line + silkscreen updated
    [Project_design_v1.0.brd, Project_design_v1.0.sch]
2017-11-29 final version of the PCB, final BOM, and .gitignore file added; let's start coding
    [Adafruit USB LiIon-LiPoly Charger.brd, Adafruit USB LiIon-LiPoly Charger.sch, BOM_Project_design_v1.0.xlsx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]
2017-12-05 Update of the Arduino code, RGB LED class added, Library edited
2017-12-12 Arduino Code updated
2017-12-18 final commit before presentation, I had fun
    [projectdesign_v1.0.xlsx, projectdesign_v1.0_10ku.xlsx]
